Shisuibi/TimeRGB/README.md

<HTML>
	<DIV ALIGN="Center" STYLE="Width:100%;"><TABLE>
		<TR><TD ALIGN="Center" COLSPAN="3">
			TimeRGB
		</TD></TR>
		<TR><TD ALIGN="Center" COLSPAN="3">
			<SPAN STYLE="Font-Size:24px;">
				Website introducing Portable NTP Clock Timer Mood Light<BR>
				<A HREF="https://crystalpalace.web.fc2.com/">https://crystalpalace.web.fc2.com/</A><BR>
			</SPAN>
		</TD></TR>
		<TR><TD>
			プリント基板10
		</TD><TD>
			電子回路図10
		</TD><TD>
			プリント基板11
		</TD></TR>
		<TR><TD>
			実機内観
		</TD><TD>
			HelpText
		</TD><TD>
			実機外観10
		</TD></TR>
	</TABLE></DIV>
</HTML>
