Shisuibi/TimeRGB/Sketch/Global.h

//==============================================================================//
//	Portable NTP Clock Timer Mood Light "TimeRGB" I/O Sketch for ESP32-S3-Zero	//
//				Implemented by Shisuibi --Grand Master Sorcerian--				//
//==============================================================================//


//==============================================================================//
#include	<SPIFFS.h>									//	SPIFFSライブラリ
#include	<WiFi.h>									//	Wi-Fiライブラリ
//==============================================================================//


//==============================================================================//
#define		UpperDefinition
//==============================================================================//


//==============================================================================//
#include	"Function.h"								//	定義ファイル（基本機能）
//------------------------------------------------------------------------------//
#include	"SegLed.h"									//	定義ファイル（7セグLED）
#include	"Clock.h"									//	定義ファイル（クロック）
#include	"NeoPix.h"									//	定義ファイル（NeoPixel）
#include	"Trans.h"									//	定義ファイル（シリアル通信）
//==============================================================================//


//==============================================================================//
#undef		UpperDefinition
//------------------------------------------------------------------------------//
#define		LowerDefinition
//==============================================================================//


//==============================================================================//
#include	"Function.h"								//	定義ファイル（基本機能）
//------------------------------------------------------------------------------//
#include	"SegLed.h"									//	定義ファイル（7セグLED）
#include	"Clock.h"									//	定義ファイル（クロック）
#include	"NeoPix.h"									//	定義ファイル（NeoPixel）
#include	"Trans.h"									//	定義ファイル（シリアル通信）
//==============================================================================//


//==============================================================================//
#undef		LowerDefinition
//==============================================================================//
